JabawokJayUK/TheCylon/docs/images/breadboard-v3-complete.png

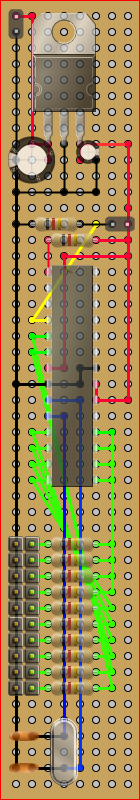
docs/images/breadboard-v3-complete.png
