JabawokJayUK/TheCylon/docs/images/cylon-breadboard.png

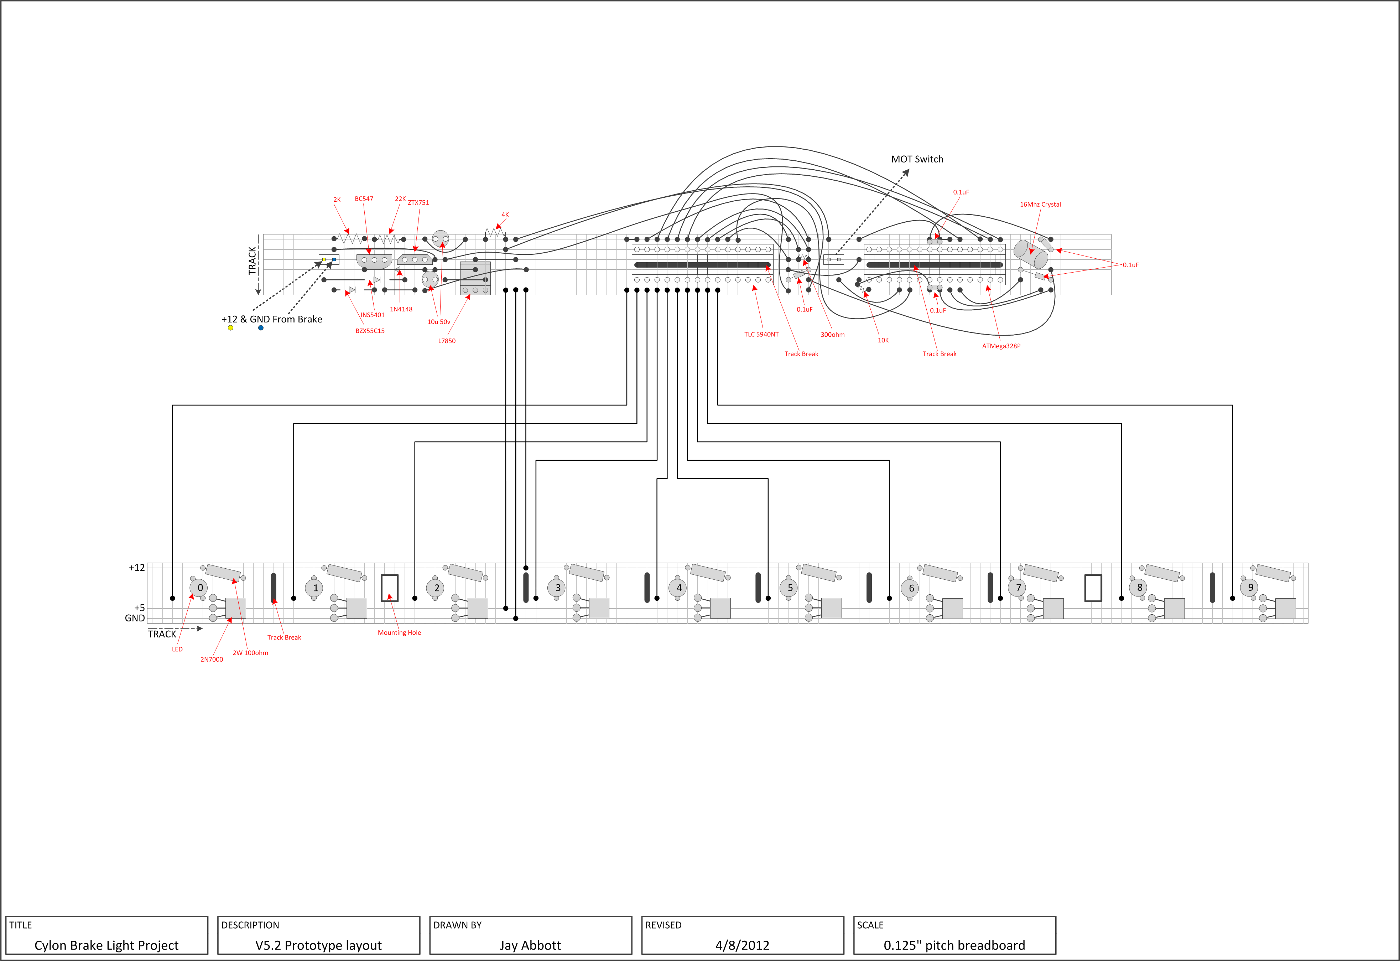
docs/images/cylon-breadboard.png
