JabawokJayUK/TheCylon/docs/images/schematic-v2-web.jpg

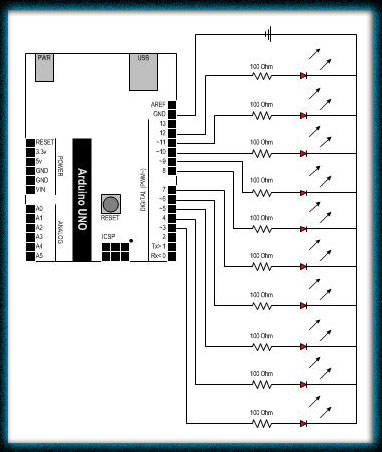
docs/images/schematic-v2-web.jpg
