JabawokJayUK/TheCylon/docs/images/schematic-v2.jpg

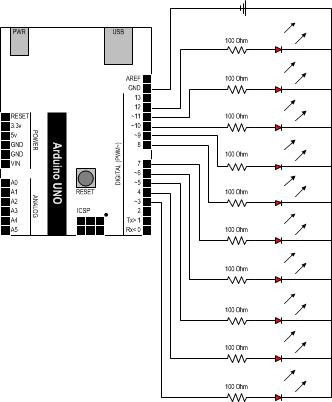
docs/images/schematic-v2.jpg
