JabawokJayUK/TheCylon/docs/images/schematic-v3-softpwm.jpg

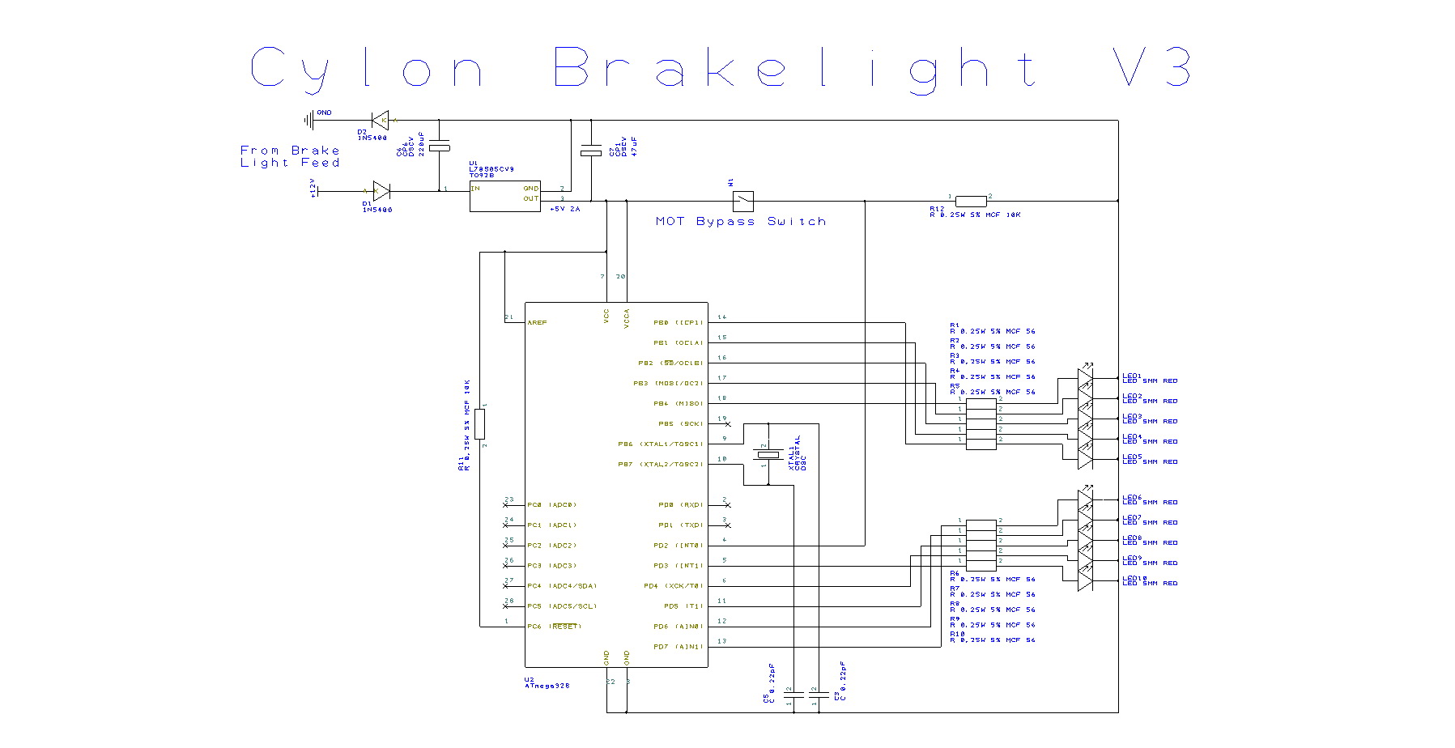
docs/images/schematic-v3-softpwm.jpg
