JabawokJayUK/TheCylon/hardware/Technical Schematic V5.2 - Schematic.pdf

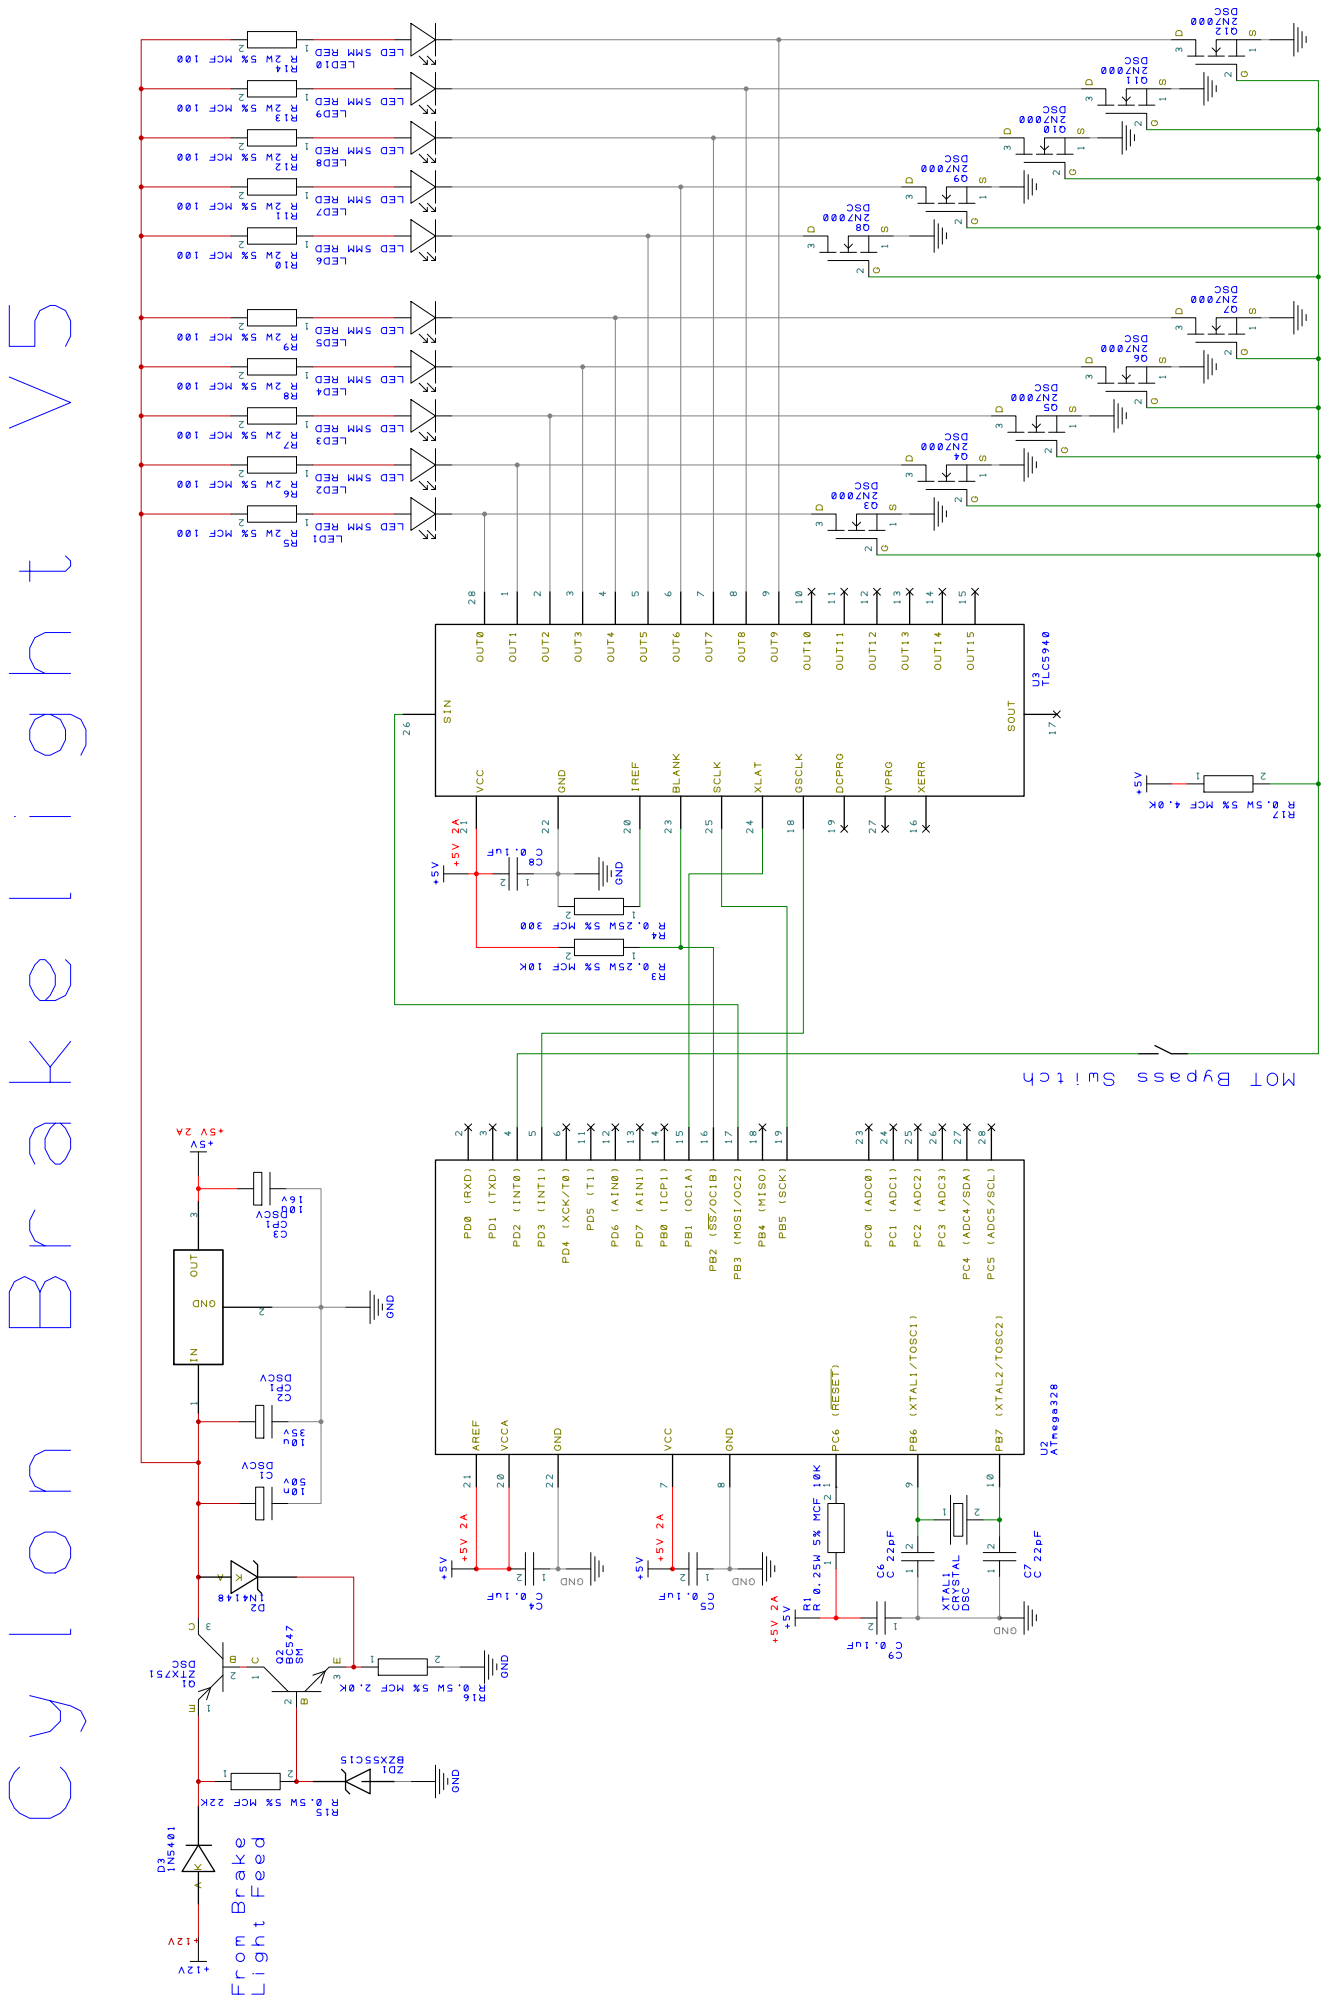
[picture p7: page 1]
