JabawokJayUK/TheCylon/(list of files, drawings)

Other design files:
hardware/designspark/Technical Schematic V4 Instant On.pcb
hardware/designspark/Technical Schematic V5.2.pcb
